agleason6/Arduino-MPPT-Solar/Debug_Notes.odt

Serial Interface Debug

Problem: Arduino Pro Mini with FTDI adapater will not respond or read serial commands, however it can download code and transmit serial with no issues (well there was one issue, when trying 9600 baud transmit showed up as garbage on serial terminal, so I increased to 115200 and it solved).

I have confirmed the following:

1. Arduino settings match the board (3.3V 328P 8MHz)
2. Added my user to the dialout group with “sudo usermod -a -G dialout adam”
  1. USB Serial devices are part of the dialout group, this gives Arduino run by adam permissions to the device handle
3. The serial output of the FTDI board that connects (TBD precisely) to the Pro Mini does receive proper serial
  1. Using Waveforms and Analog Discovery 2
    1. I ran a logic analyzer on the RX and TX pins and when typing Y into the Serial Monitor I can see the Y character and the line feed character being tranmitted properly; logic decoded characters and it matched expected.
    2. I sniffed the RX line with the oscilloscope and captured the Y transmission and the levels are proper 0 – 3.3V.
4. I am not using the RX0 in my circuit, the pin is untouched.
5. I can download code just fine, which uses the RX pin to receive the code.

These confirmations prove that there is no issue with the Arduino Serial monitor, FTDI software, or Linux permissions as the FTDI USB→Serial is generating serial properly. The issue lies on the Arduino Pro Mini.

Y character loaded into Serial Monitor ready to transmit

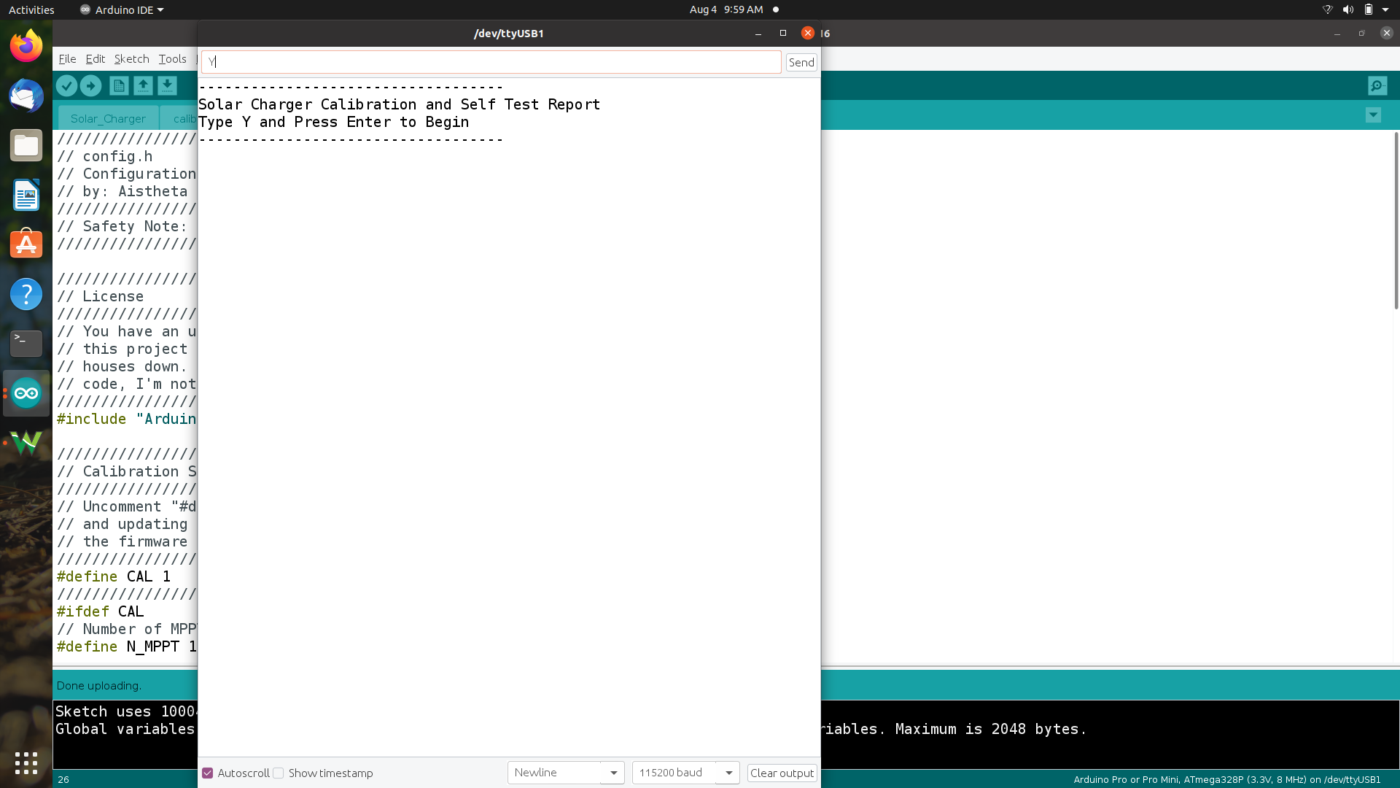
[picture p1: figure]

Y character ready to transmit with Waveforms logic ready to capture

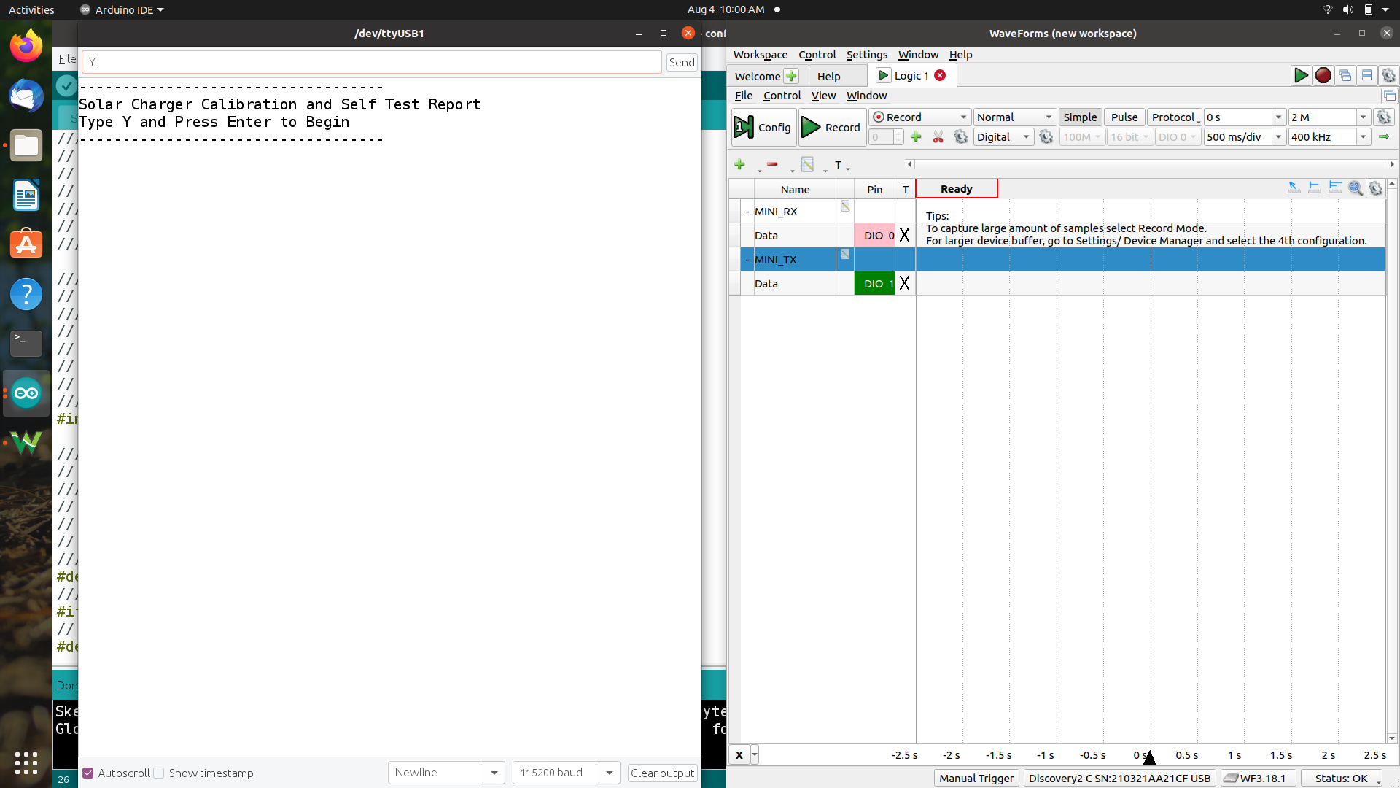
[picture p2: figure]

Logic capture showing decoded values (Y + LF)

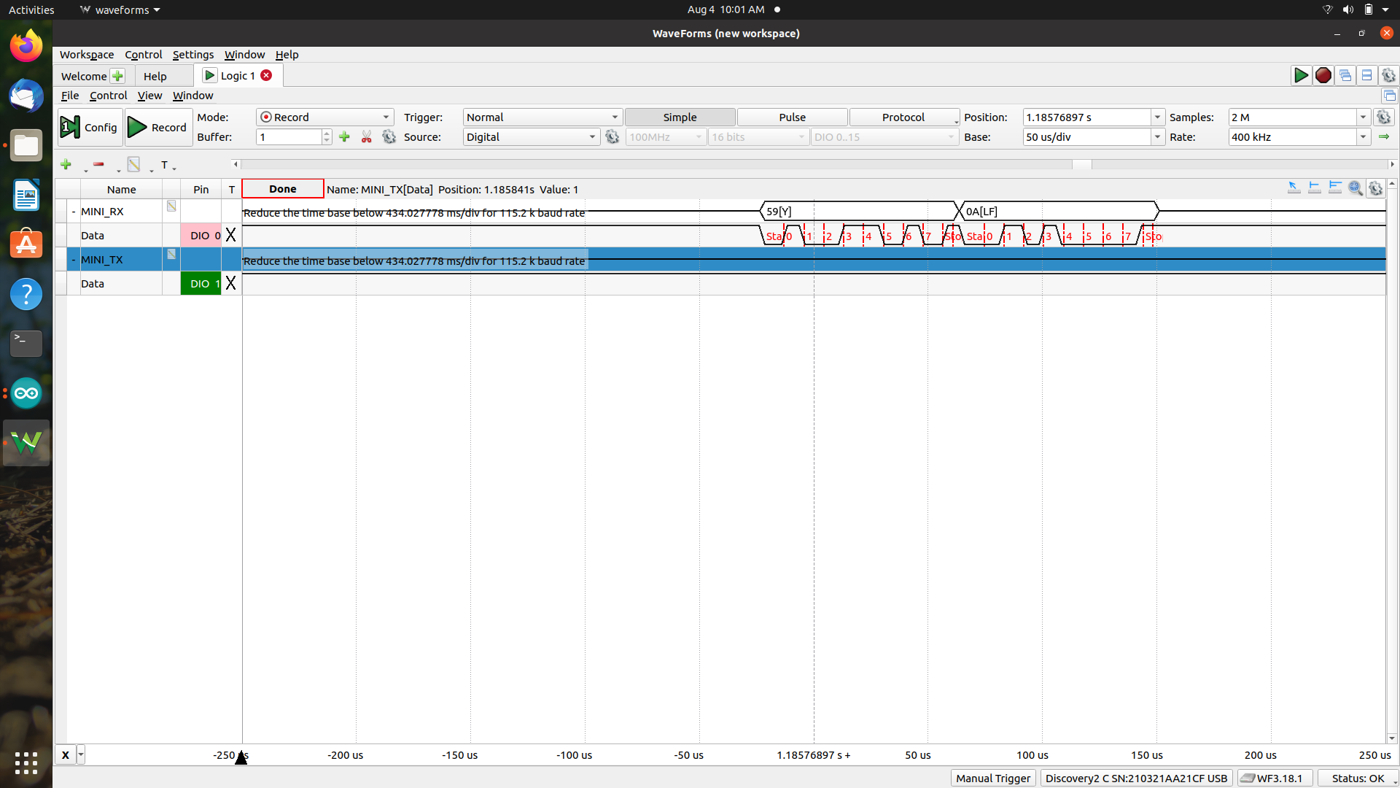
[picture p3: figure]

Close up of logic capture

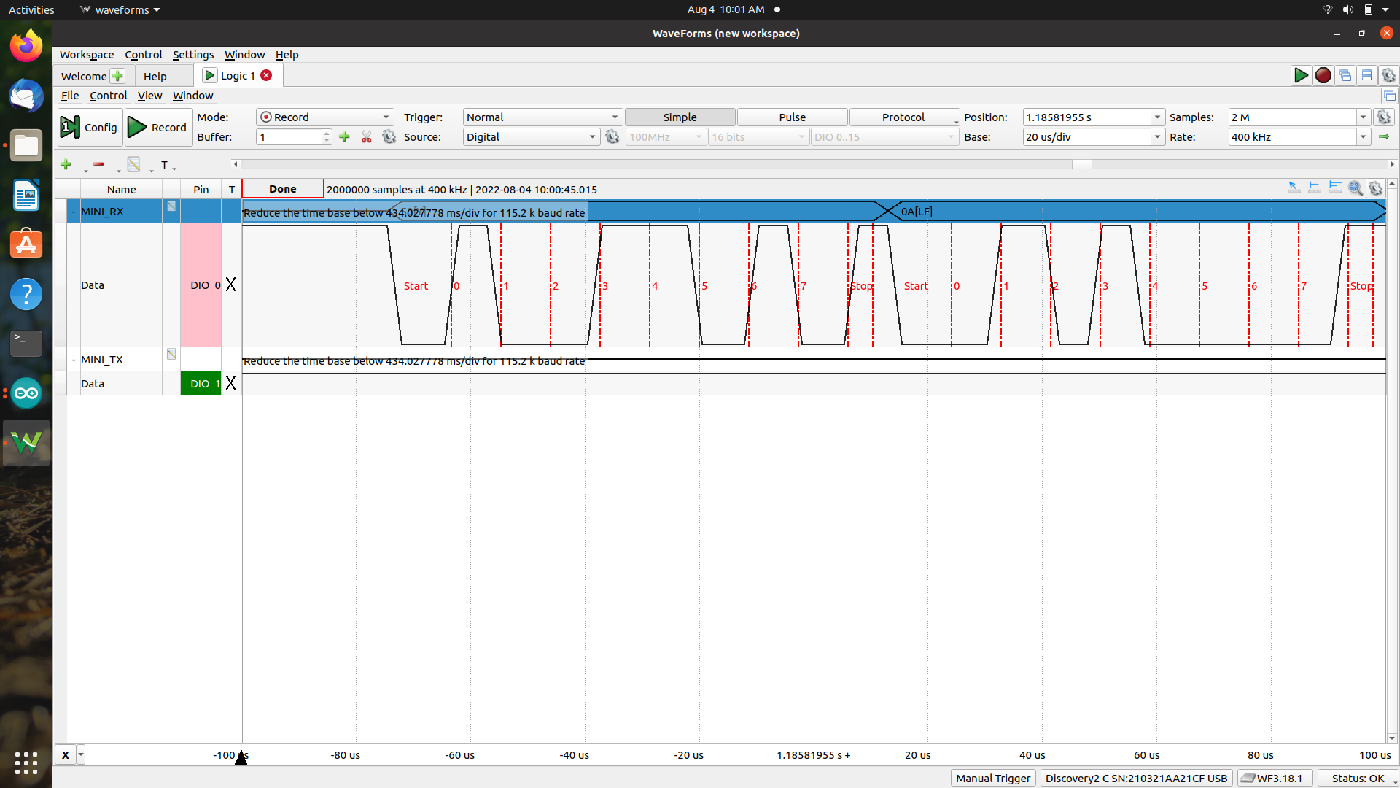
[picture p4: figure]

Serial Monitor showing no response

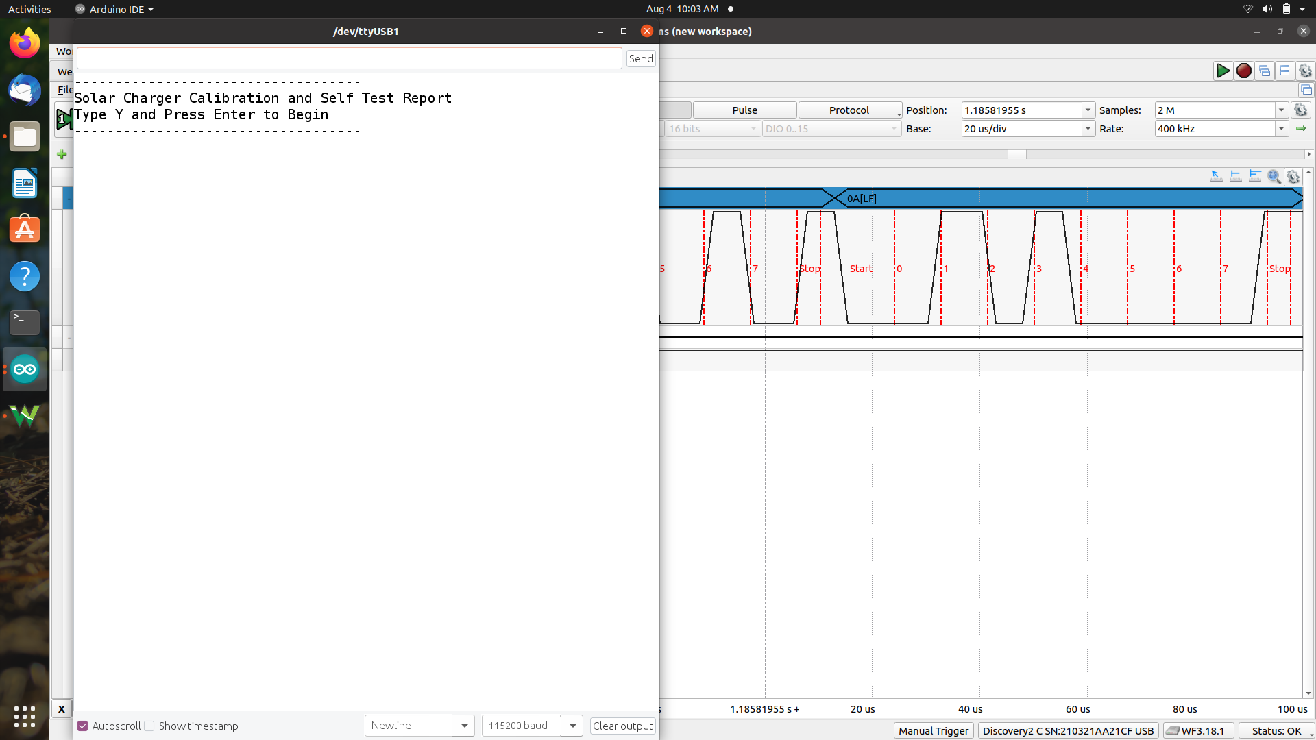
[picture p5: figure]

Scope capture of a new transmit (Y again)

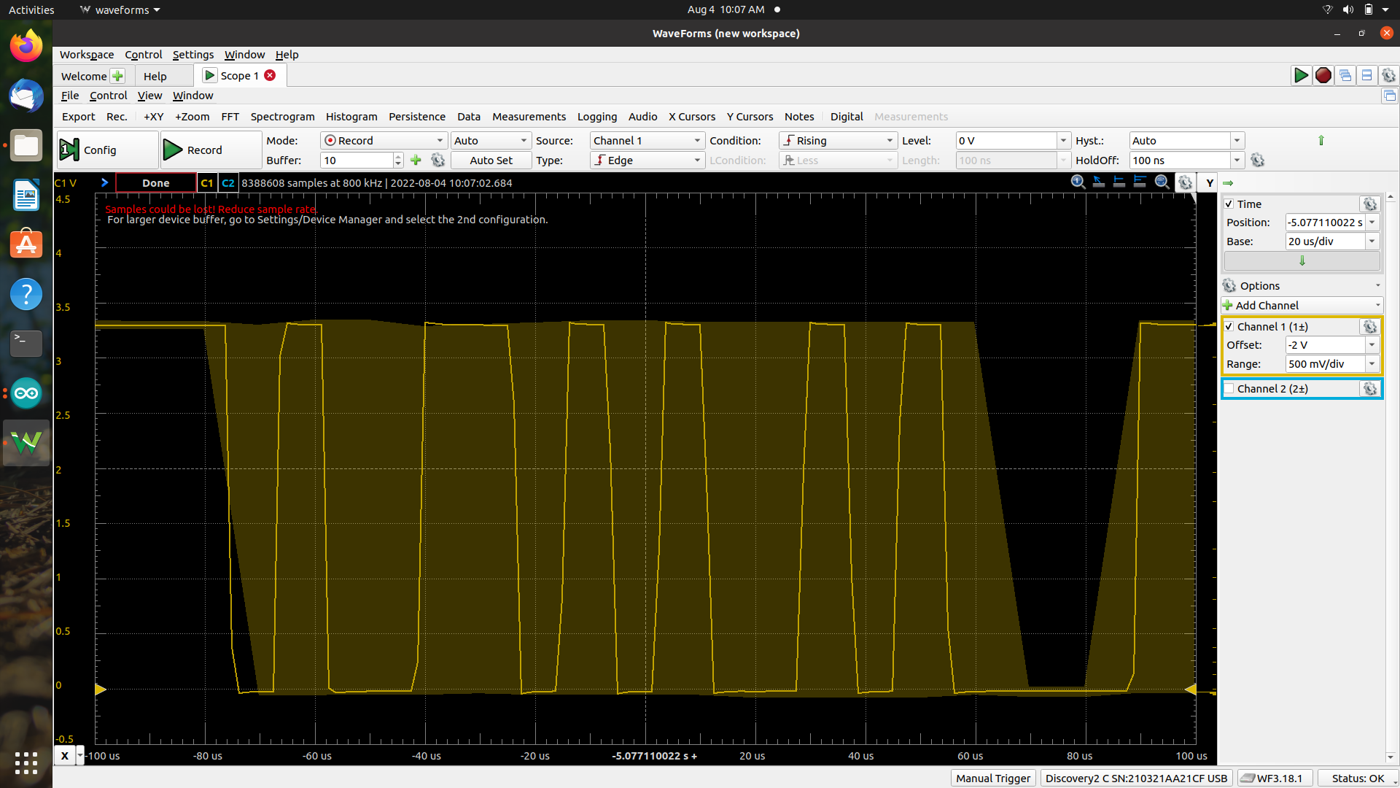
[picture p6: figure]

Scope capture with cursor showing 3.3V level

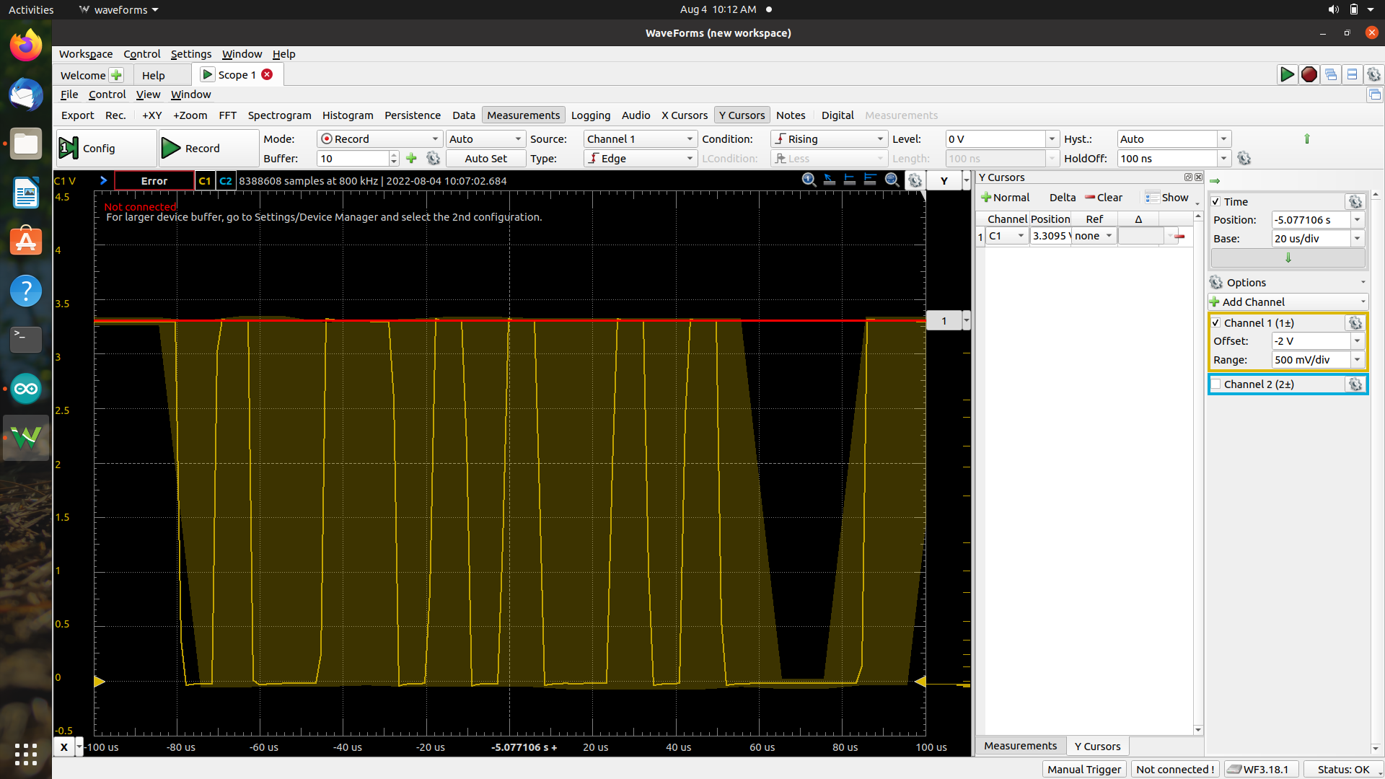
[picture p7: figure]

Snippit of code highlighting print line that would get printed if Serial was ready (received something). “Serial Monitor showing no response” above shows that nothing gets printed, hence Serial.available is never > 0 (nothing received).

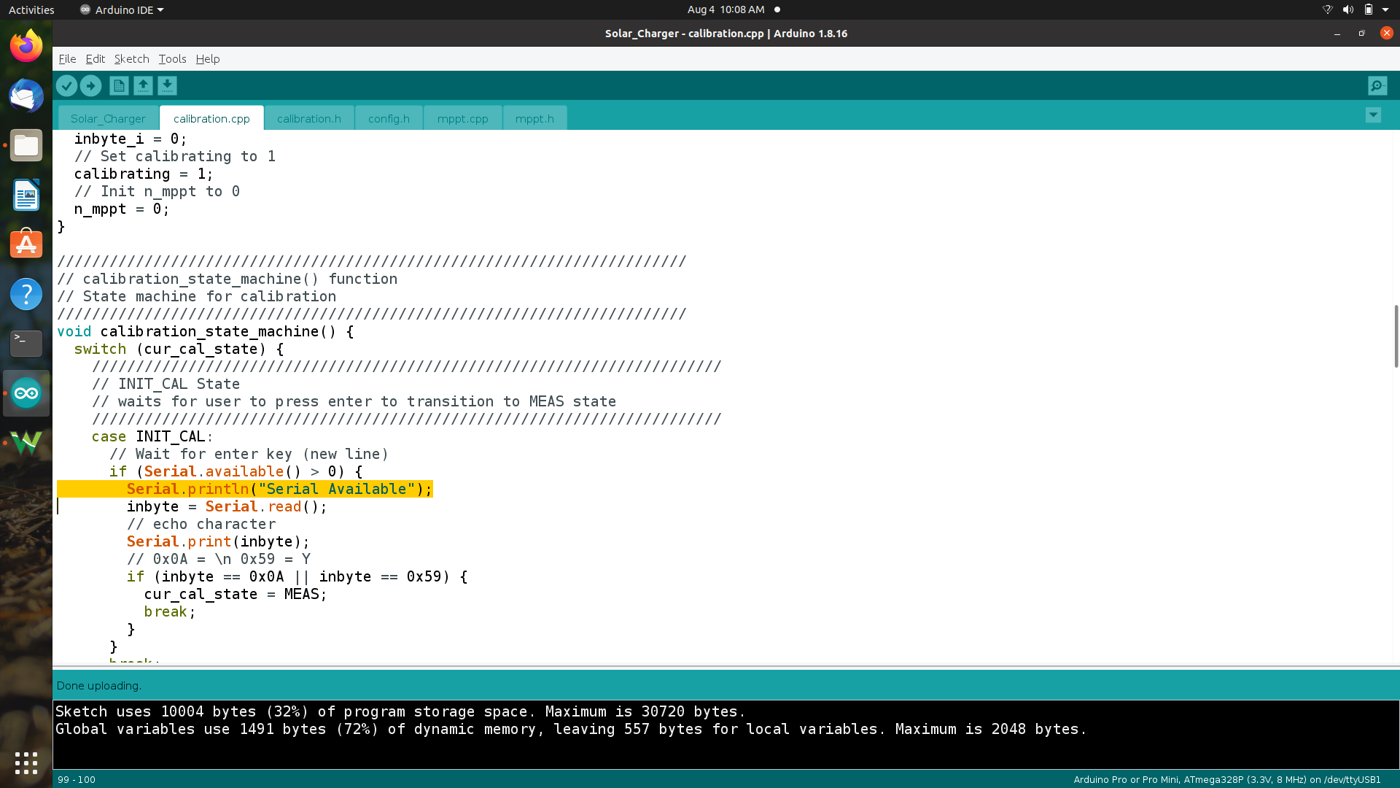
[picture p8: figure]

Modified code by adding print one level above the scope of Serial available to prove if code reaches the INIT_CAL state (printes Test if INIT_CAL)

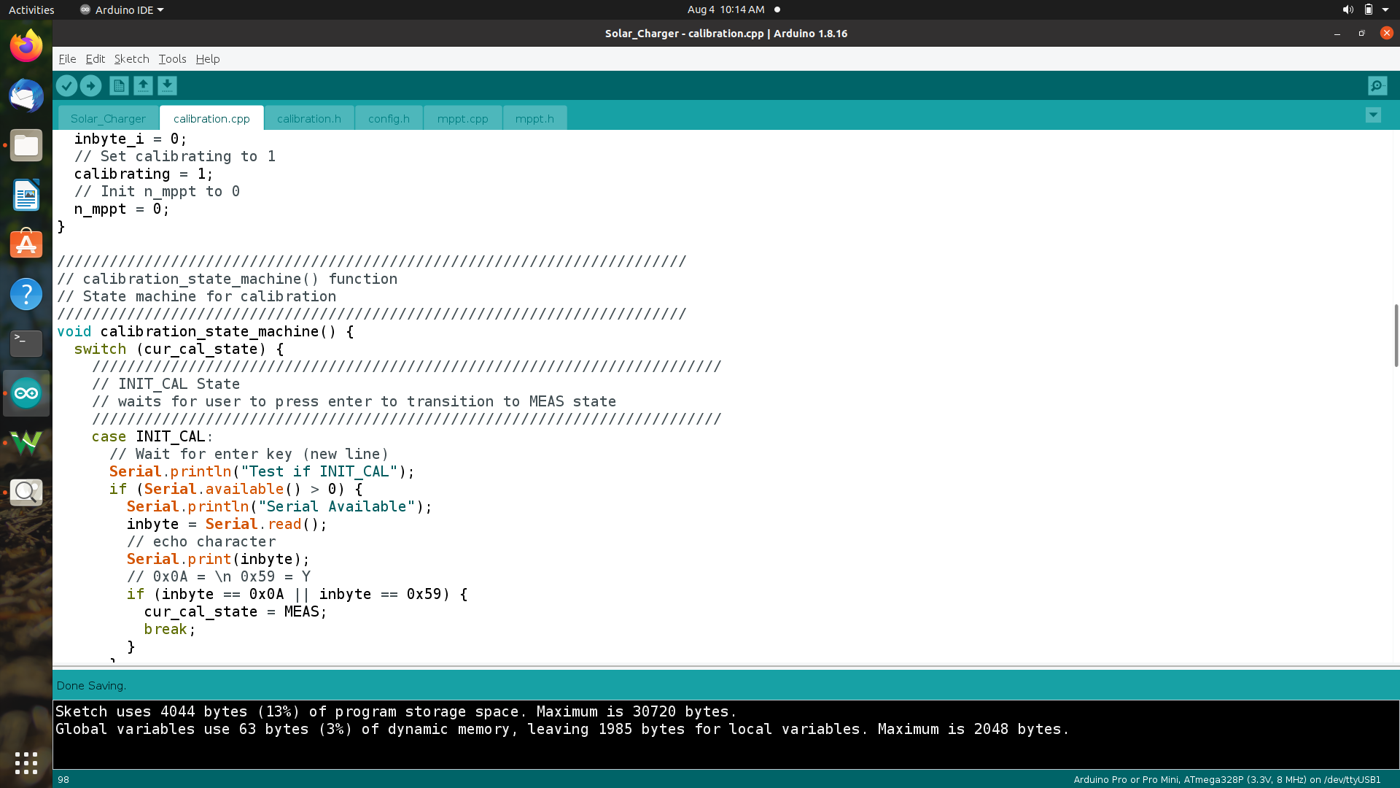
[picture p9: figure]

Log proving that it does reach that part of the code, no Y character was sent, it started printing on startup and didn’t stop.

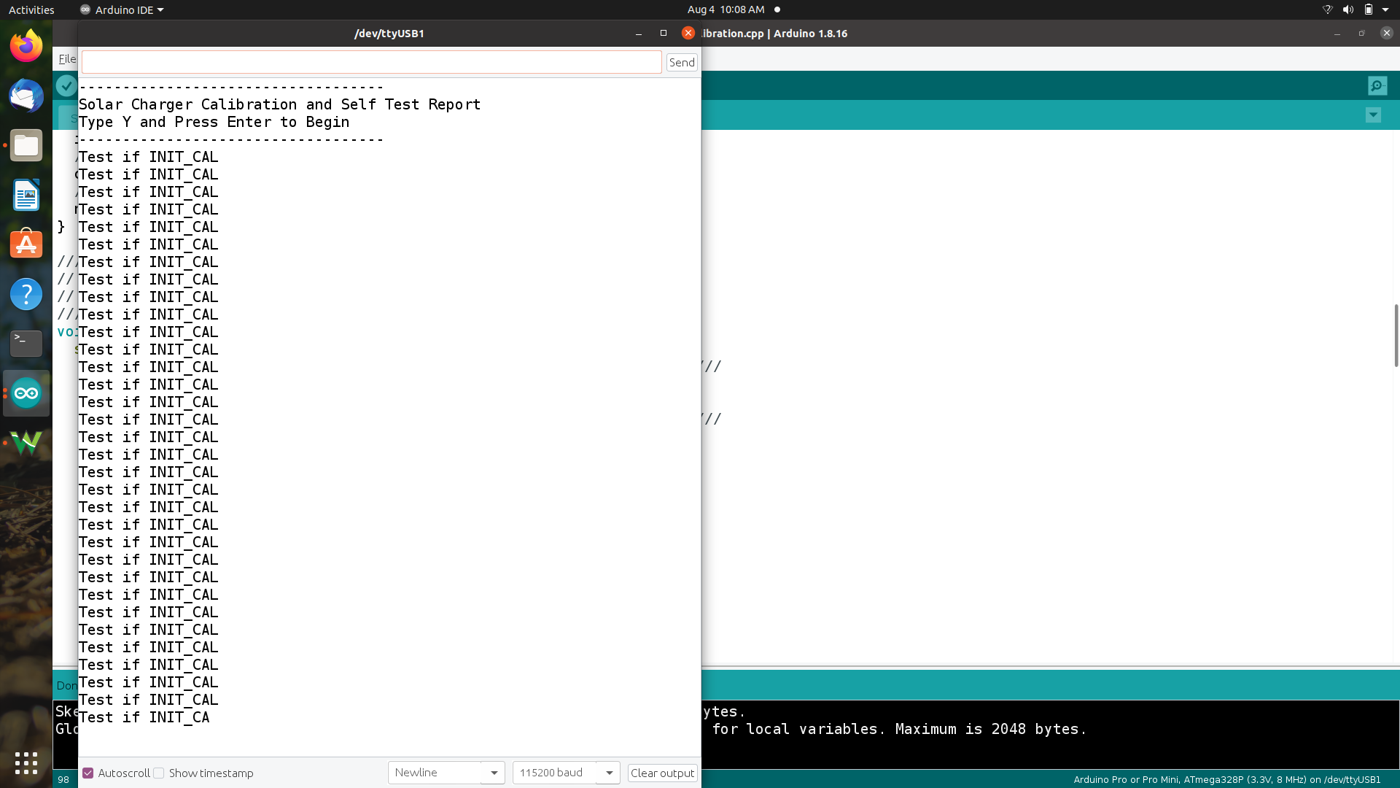
[picture p10: figure]

FTDI Adapter Schematic

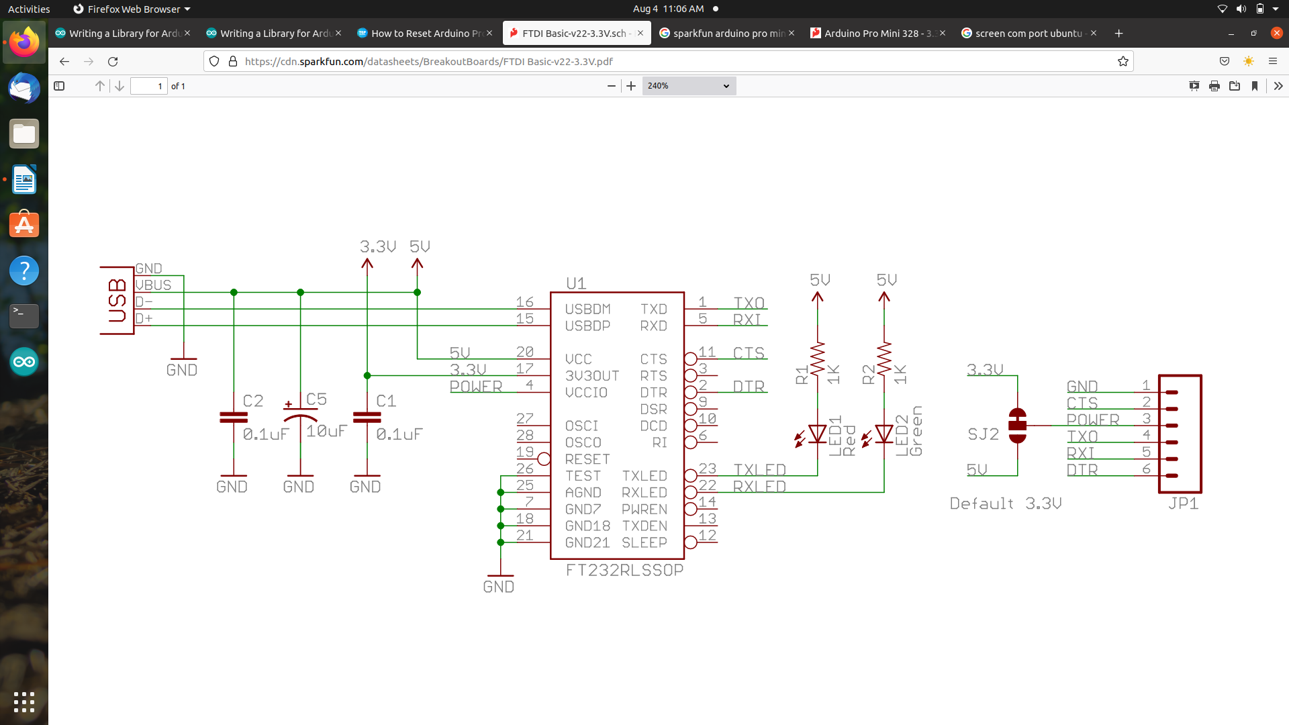
[picture p11: figure]

Arduino Pro Mini Schematic

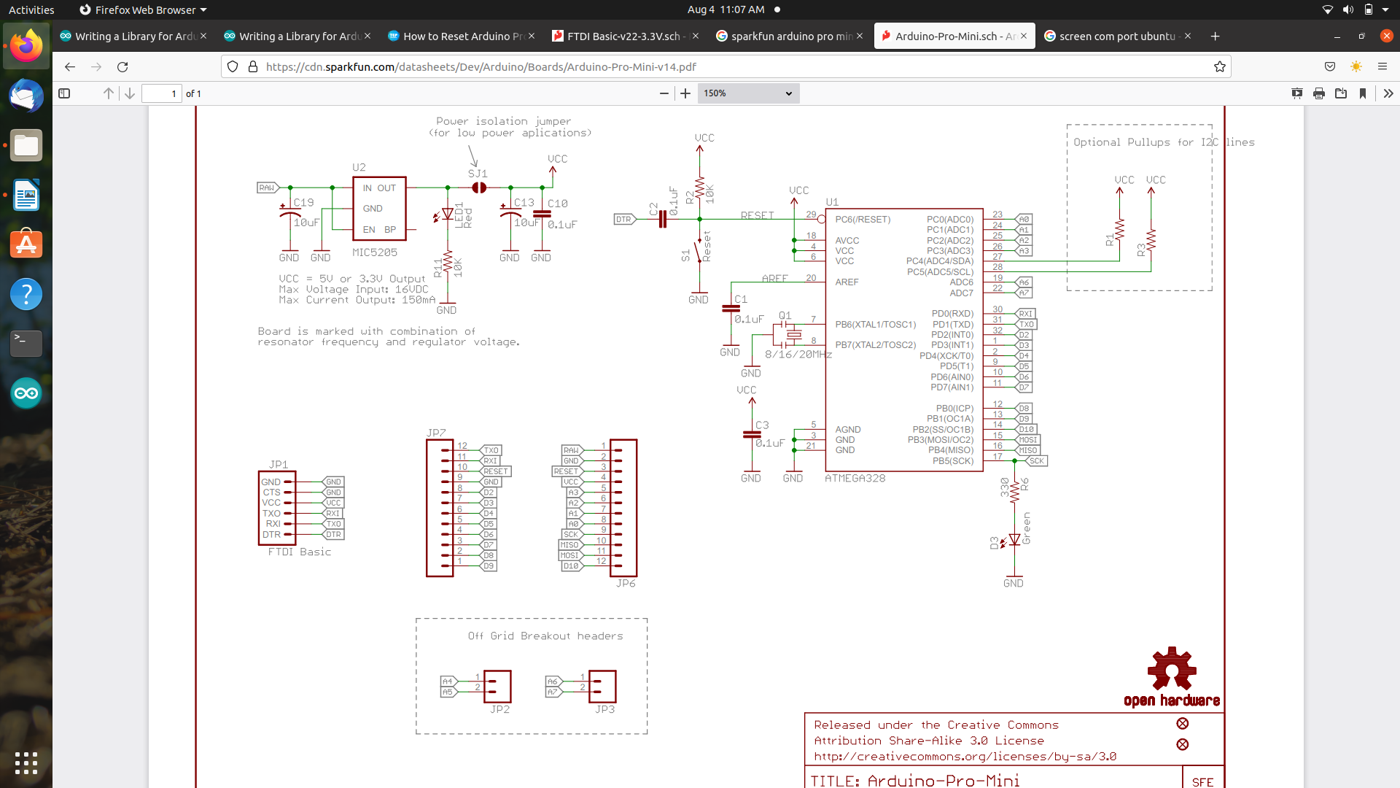
[picture p12: figure]
