agleason6/Arduino-MPPT-Solar/Solar_Charger/Solar_Charger.ino

////////////////////////////////////////////////////////////////////////
// Solar_Charger.ino
// Solar Charger
// by: Aistheta Gleason
// Charges a 12V lead-acid battery using a 100W solar panel (23V)
// Requirements: Arduino UNO or Arduino Pro Mini, Buck Converter Circuit
// 12 Automotive Battery, 100W (23Voc) Solar Panel, DMM
////////////////////////////////////////////////////////////////////////
// Safety Note: Read the README!!! Keep Battery in well ventilated area
////////////////////////////////////////////////////////////////////////

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
////////////////////////////////////////////////////////////////////////
// Includes
////////////////////////////////////////////////////////////////////////
// MPPT Library
#include "mppt.h"
// Config Library
#include "config.h"

////////////////////////////////////////////////////////////////////////
// setup() function
// Arduino Main Setup Function
////////////////////////////////////////////////////////////////////////
void setup() {
  // Setup the charger
  setup_charger();
}


////////////////////////////////////////////////////////////////////////
// loop() function
// Arduino Main Loop Function
////////////////////////////////////////////////////////////////////////
void loop() {
  // Run Charger State Machine
  charger_state_machine();
}
